jarif3658/HardwareProject/README.md

# HardwareProject
Speech- and hearing-impaired individuals face communication barriers as sign language requires prior knowledge. This low-cost wearable smart glove uses flex sensors to detect finger-bending angles and an Arduino Nano with a Bluetooth module to transmit recognized gestures wirelessly to phones or computers in real time.
